jacobporters/project-03-sensor-datalogger/(commit log)

2026-06-29 Add all project files: firmware, dashboard, wiring, BOM, build notes
2026-06-29 Add hardware/BOM.csv
    [BOM.csv]
2026-06-29 Correct OLED display description in BOM
    [BOM.csv]
